BumbleBee1010/PowerGen/BOM.csv

Item | Qty | Supplier | Cost/item | Total Cost | link
Nema 23 stepper 76mm | 1 | StepperOnline | $20.66 | $20.66 | https://www.stepperonline.co.uk/e-series-nema-23-bipolar-1-8deg-1-85nm-261-98oz-in-2-8a-57x57x76mm-4-wires-23he30-2804s.html
18650s (3500mAh, 10.2A) | 1 | NKON | $15.60 | $15.60 | https://www.nkon.nl/en/
KF301 Screw terminal | 1 | AliExpress | $2.05 | $2.05 | https://www.aliexpress.com/item/1005008580990368.html?curPageLogUid=nCARVI84xcH6
SR560 Schottky Diode | 1 | AliExpress | $2.20 | $2.20 | https://www.aliexpress.com/item/4000208639579.html?curPageLogUid=KZdQzmtmbVty
4700µF 63V & 100nf Capacitors | 1 | AliExpress | $2.75 | $2.75 | https://www.aliexpress.com/item/1005007126687566.html?curPageLogUid=vWh53siqYBF6
15A Fuse and Holder | 1 | AliExpress | $1.32 | $1.32 | https://www.aliexpress.com/item/1005006124536260.html?curPageLogUid=WMF4yeiIpJ0t
XL4016 buck convertor | 1 | AliExpress | $4.00 | $4.00 | https://www.aliexpress.com/item/1005009522430286.html?curPageLogUid=dfahT3j4xlzW
USB C dual charger outputs | 2 | AliExpress | $1.08 | $2.16 | https://www.aliexpress.com/item/1005007300706712.html?curPageLogUid=yBAYnGsXpxPi
Switches (2 pin) | 1 | AliExpress | $1.35 | $1.35 | https://www.aliexpress.com/item/4001365460466.html?curPageLogUid=wbdxnN6zWWvf
3S 40a balanced BMS | 1 | AliExpress | $1.80 | $1.80 | https://www.aliexpress.com/item/1005006823428482.html?curPageLogUid=8r3HgzhKqDu4
Bearings | 1 | AliExpress | $1.35 | $1.35 | https://www.aliexpress.com/item/1005007181453855.html?curPageLogUid=mYFJXlC5d8Em
Wire & nickel strips | 1 | AliExpress | $6.50 | $6.50 | https://www.aliexpress.com/item/1005011620457618.html?curPageLogUid=djvXqMuvhf36
JLC stuff | 1 | JLC PCB & 3DP | $15.00 | $15.00 | https://cart.jlcpcb.com/
Exxhange rate fluctuation | 1 | Xe | $0.75 | $0.75 | https://www.xe.com/en-gb/currencyconverter/
Estimated total shipping | 1 |  |  | $25.50
