BumbleBee1010/PowerGen/CAD/54T gear.step

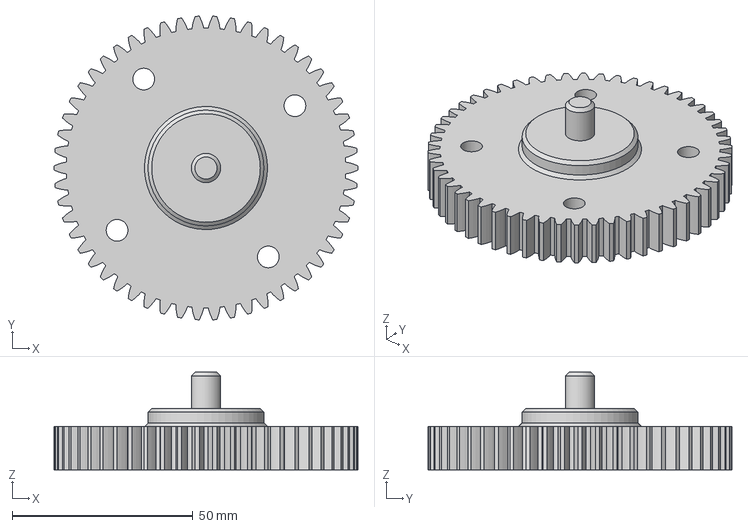
[picture p1: CAD file, 2026-11-12]
CAD/54T gear.step
84.0 x 83.9 x 27.0 mm
