BumbleBee1010/PowerGen/CAD/Mount.step

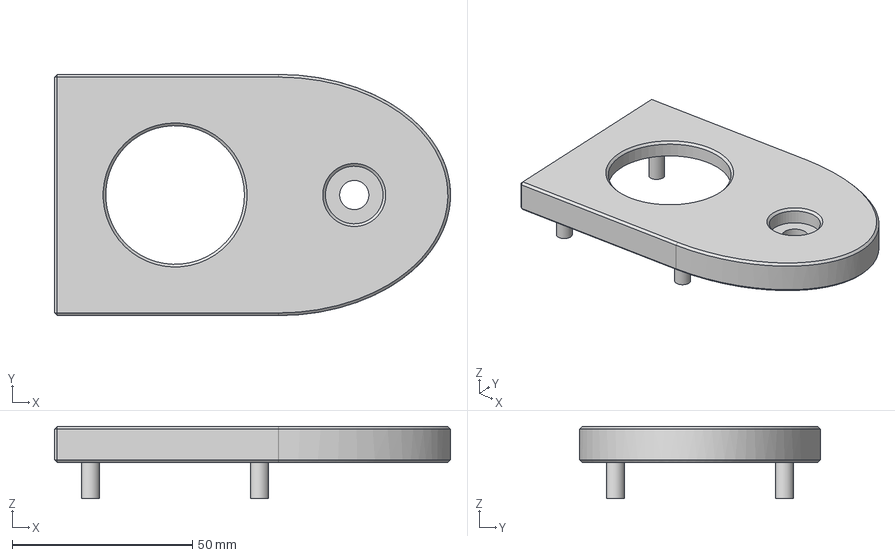
[picture p2: CAD file, 2026-11-12]
CAD/Mount.step
110.0 x 67.0 x 20.0 mm
