BumbleBee1010/PowerGen/CAD/12T gear.step

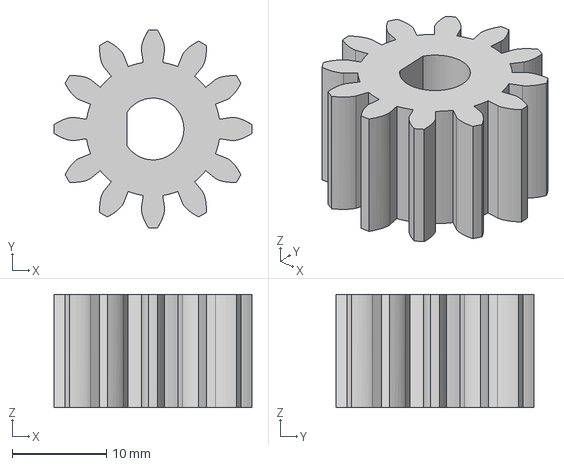
[picture p3: CAD file, 2026-11-12]
CAD/12T gear.step
21.0 x 21.0 x 12.0 mm
