BumbleBee1010/PowerGen/CAD/18650 holder x2 (1).step

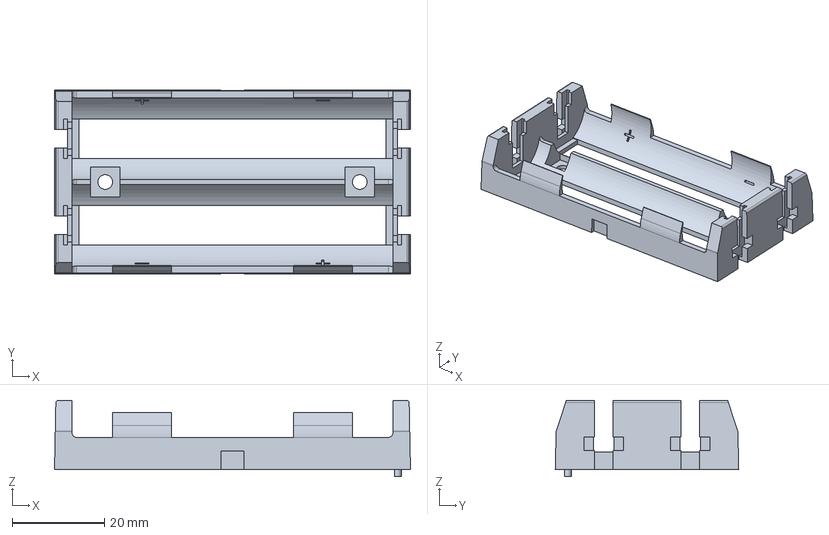
[picture p4: CAD file, 2026-11-12]
CAD/18650 holder x2 (1).step
77.2 x 39.8 x 16.5 mm
