BumbleBee1010/PowerGen/(list of files, cad)

Other CAD files:
CAD/Handle.step
CAD/Knob.step
CAD/12T gear.f3d
CAD/18650 holder x2 (1).f3d
CAD/54T gear.f3d
CAD/Handle.f3d
CAD/Knob.f3d
