BumbleBee1010/PowerGen/(list of files, drawings)

Other design files:
PCB/SCH_PowerGen-v2_2026-11-12.json
