BumbleBee1010/PowerGen/JOURNAL.md

# Power Gen: devlog

<!-- Generated by Half Life from project qk10rxavlfxbqmpknzku5tpf. Edits here are overwritten on the next sync. -->
<!-- Generated: 2026-11-12T15:48:11.052Z -->

> [!NOTE]
> This devlog is mirrored from [Half Life](https://halflife.hackclub.com) ([open the project](https://halflife.hackclub.com/projects/qk10rxavlfxbqmpknzku5tpf)). Editing it here will not change the platform's copy, and the next sync overwrites this file.

> A portable(-ish) power generator. That is made using a NEMA 23, a gear ratio and power is made by turning a hand crank.

| Week | Tier | Hours logged | Entries |
| --- | --- | --- | --- |
| Week 5 | Tier 3 | 39h | 9 |

## Contents

1. [2026-11-06: # Research](#2026-11-06-research)
2. [2026-11-07: # PCB schematic](#2026-11-07-pcb-schematic)
3. [2026-11-08: # PCB done](#2026-11-08-pcb-done)
4. [2026-11-08: # Big Changes...](#2026-11-08-big-changes)
5. [2026-11-08: # CAD](#2026-11-08-cad)
6. [2026-11-08: # Repo](#2026-11-08-repo)
7. [2026-11-09: # Changing the PCB](#2026-11-09-changing-the-pcb)
8. [2026-11-11: # CAD](#2026-11-11-cad)
9. [2026-11-12: # GitHub Repo](#2026-11-12-github-repo)

## Design

### 2026-11-06: # Research

**4.75h**

# Research
## Steppers
I was looking around (researching?) for what to use for the actual power generation bit. I looked at DC motors for a bit but in the end opted to go for steppers. Then i spent a while looking at different places/ websites. I was undecided between the nema 17 and nema 23 so i was just kinda looking at both. I looked in quite a lot of places, like AliExpress, StepperOnline, Ebay and JLCMC (i didn't know there were so many...) .







In the end i think the ebay one is best. (it is also in GBP btw) this is because of the immense amount of shipping costs. I did decide to go with a nema 23 instead of 17 but it is 2 as heavy. I probably spent to long looking at steppers but i think it was better I got a good one that saved time.

#  Batteries
To be honest when i was looking at batteries i was thinking the cheapest one are best but they are not. i when with some reasonably priced 3000mah 20A 18650 which are good and have decent capacity and high ish discharge rate which will be good for multiple charging outputs.



# Planning
I also looked at what I will use/ incorporate into the project. i decided I will use a esp32 and screen to act as a stats display. I am planning to make the thing have multiple charging outputs hopefully, probably some usb a and usb c. I might add sth like below to charge devices like phones and earbuds via cable



### 2026-11-07: # PCB schematic

**3h**

# PCB schematic
I started my pcb schematic and found the parts. I spent a while researching to make sure everything would work together. For example, I was originally going to us a 50v max capacitor but i found out the nema 23 could produce up to 60v! Because of this i am also going to add a fuse. I was also looking how best to attach wires from the stepper to my pcb and I figured using screw terminals is a less permanent way but still as secure as directly soldering them on.



# Parts
I also found some of the parts I will need. As i found the parts, mostly on AliExpress, I added them into the schematic. I found bit like 2 pin screw terminal which I'll use and a good fuse to make sure I don't short circuit anything, hopefully...





### 2026-11-08: # PCB done

**6h**

# PCB done
I wired everything on the PCB up and did the layout. I picked all the parts out and use net ports to connect them together.  I put parts in their own boxes with titles so you can tell what they are. I did the PCB layout so that the components are neatly laid out. I made sure to double check the screw terminals are facing outwards and on the outside of the board so you can access them. I also labelled which bit of the screw terminals is which wire so I know when I am assembling and putting the wires in.





The PCB also looks good. but it is quite funny how large the capacitor is 22mm diameter.



# Bom
I did the BOM. I found most of the parts but then i ended up over budget. So I didn't know what I will do.



# Bom changes
I found a marginally cheaper nema 23 stepper on stepper online which saved me about $5. I also decided to go with cheaper batteries which saved me another $5. so my cost is sitting at $90 but I still don't the PCB and hand crank though...





### 2026-11-08: # Big Changes...

**5.25h**

# Big Changes...
## Cuts
In short, my BOM is too much. To cut costs, I got rid of the Usb A ports, USB c PD port, and the fan  (fan was for usb c PD bit) this saved me another $10.



## BMS
I also moved to a 3s configuration, so this also saved me some money on the BMS.



# PCB
Arguably the biggest and most time consuming change i did was the PCB. I had to change the schematic and PCB layout. I got rid of some of the screw terminals which were unneeded and I rearranged the components.





## BOM
I updated my BOM to include the PCB which is only $4 + shipping. The rest of my budget will be used for the hand crank and gear ratio. Hopefully I can fit this within this budget.





### 2026-11-08: # CAD

**4.75h**

# CAD
## Stepper
I started by deriving the nema 23 stepper into fusion. I got it from grabcad but I had to fix the mistakes. I changed it so the output was a 6.35mm d shaft, originally it was circular which is wrong.



## Gears
Then I created the gears with GF Gear Generator, a addon/ utility I installed in fusion. So I created the two gears, a 12T one and a 54T one (T = tooth), that was fairly straightforward, I just need to make sure the module was 1.5, good for printing and a decent thickness, I chose 12mm. Also later, but I'll say now on this topic, but I chamfered the top and bottom of the gear to stop elephant foot, a problem when the edges of the gears splay outward.


## Mounting
When I was figuring how to mount the gears, I decided to use a faceplate attached to the stepper with a hole for the bearing to slot into. The are alignment rods of one side to fix the plate to the stepper. The plate also wraps around the doors of the stepper.


## Handle
The handle is made up of two parts. The main bit which attaches to the large gear via alignment pins and M3 screws and the knob which is attached via a bearing at the end of the handle. The entire handle is about 90mm long to give a balance of leverage and turning comfort. I made the knob bit to have a pin/ bit sticking out the bottom to fit into a bearing so it can spin easier. There is also a cut out with tolerances in the main handle for the bearing to push fit inside.





### 2026-11-08: # Repo

**3h**

# Repo
Added stuff to Github repository and did README and included pictures. This took me a while because i decided to leave the readme to the end which was vey clever of me. So it took me a while. I used pictures of the CAD design and PCB I did.







### 2026-11-09: # Changing the PCB

**5h**

# Changing the PCB
I was going to do a case and finish the CAD. But I couldn't think of a good small layout for the entire thing, mainly because the PCB was 75x75mm and the the capacitor protruded off it another 40mm so took up a lot of bulk. And the buck converter has heat sinks and stuff so that is quite bulky too. So in the end I redesigned the PCB to make it 60x65 which is nearly the same width as the nema 23 so it should fit next to it snugly. I did not change the schematic and only changed the layout. I had to double check the size of the capacitor because the one in my PCB 3d view was just a placeholder and not the actual thing so it was massively oversized for some reason. If you look at the face plate of the nema 23 it is about that size + 5mm on one side so quite small. The capacitor is not as big as  in the 3D view btw...






above ones all new

below are old ones




I didn't really know what order to put the pictures in but they are there. The size of the capacitor and how I had to orient the picture is quite funny even though it is completely the wrong size ;)

# Wiring
Also changing the PCB made me think about wires and I was originally planning to use 16 awg but now have decided to use 18 AWG because it is cheaper and I don't need that much Amp draw.

### 2026-11-11: # CAD

**3.75h**

# CAD
I changed the CAD design slightly and derived a 18650 holder and edited it to fit my needs. I also changed the mount slightly to make it look more aesthetical and use less material so be cheaper. I did a 1x and 2x 18650 holder to see which was cheaper, the 2x was...




new and improved mount


whole design, there will be 3 of the 18650 holders to do my 3s2p setup.

### 2026-11-12: # GitHub Repo

**3.5h**

# GitHub Repo
I wrote about my project in depth and added all the pictures related to it to finish my repository, I talked about the PCB, the CAD and what my project actually is and the BOM. I tried to write in detail but not excessively waffle, hopefully it is okay.




PCB stuff


Cad bit

# Misc
I also updated all my bits on half life, project description, ect.  and did my reels. i also got to 102.99 totally unplanned
