BumbleBee1010/PowerGen/(commit log)

2026-11-08 Sync Power Gen from Half Life
    [BOM.csv]
2026-11-08 Add images to README for CAD section
    Added multiple images to the CAD section for better visualization.
2026-11-12 Create README.me with project CAD information
    Added a README file with project details.
2026-11-12 Create README.md and PCB folder
2026-11-12 Enhance README with detailed project descriptions and images a lot
    Expanded the README to include detailed explanations of the generator's functionality, design changes, and PCB layout. Added images of the schematics and designs to enhance understanding.
2026-11-12 Revise README.md Added CAD and BOM and sorted out picture sizing
    Updated section headers for better clarity and organization. Added details about the CAD design process and BOM pricing.
2026-11-12 Update README with Bill of Materials and costs
    Added a detailed Bill of Materials (BOM) with itemized costs and suppliers.
2026-11-12 Clarify drivetrain design in README
    Updated the description of the drivetrain to clarify the gear design.
